KrzysztofGsan/GSM_Project/hardware/PCB/pdf/gi1.pdf

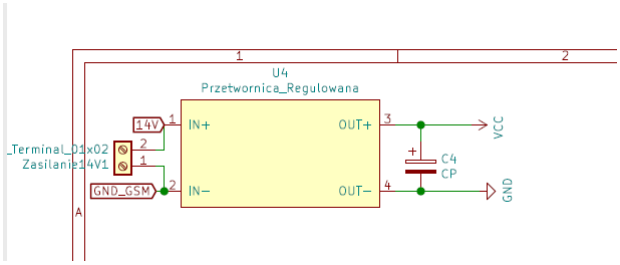
[picture p1: figure]

1. Może warto dodać zabezpieczenie przed odwrotną polaryzacją?
2. Może warto dodać TVS aby zabezpieczyć wejście zasilania przed przepięciami (gdyby np. zasilacz wybuchł :D ).

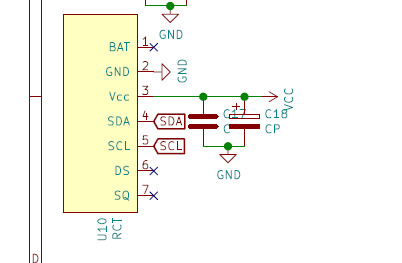
[picture p2: figure]

3. SQ albo DS. – jeden z nich chyba był odnośnie zaprogramowanego alarmu. Może warto podłączyć do wejścia Atmegi?

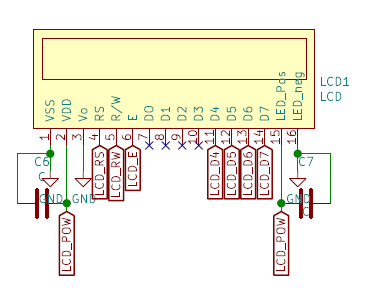
[picture p3: figure]

4. Jakie jest zasilanie LCD? 5V? Jeżeli tak, czemu Vo jest podłączone do masy? Vo to kontrast dla pixeli i sugerował bym dać tam albo potencjometr (5V – Vo – GND) albo podać tam PWM + filtr dolnoprzepustowy.

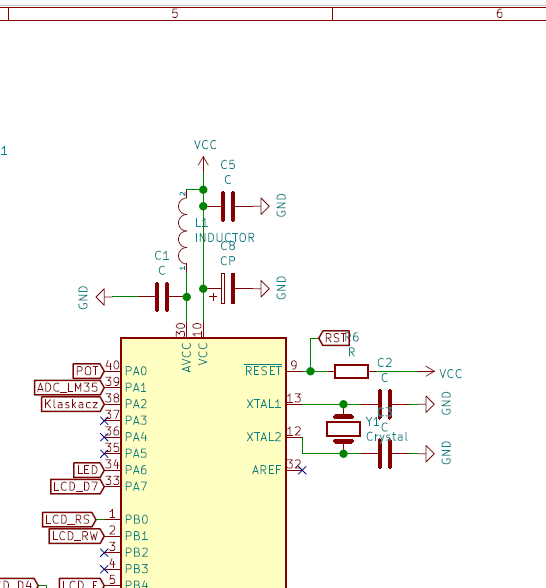
[picture p4: figure]

5. L1 możesz zastąpić rezystorem‐ będzie taniej.
6. Do pinu nr. 9 (reset) dodaj jeszcze 100 nF.

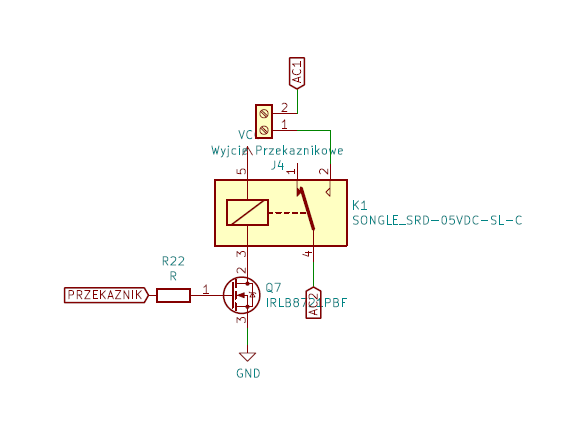
[picture p5: figure]

7. Dodaj diodę do cewki przekaźnika, katodą do Vcc, anoda do tranzystora. Unikniesz przepięć – uszkodzeń tranzystora.

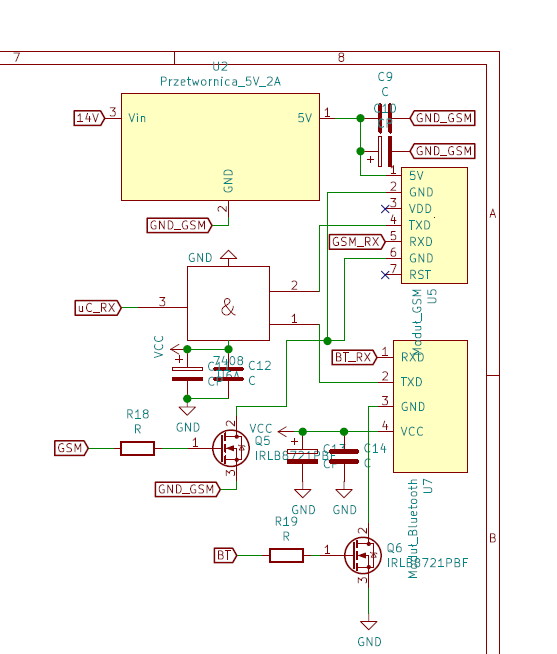
[picture p6: figure]

8. Jak w punkcie 1 i 2 – wspólne dla wejścia zasilania.
