KrzysztofGsan/GSM_Project/hardware/PCB/pdf/GSM_ATMEGA16A.pdf

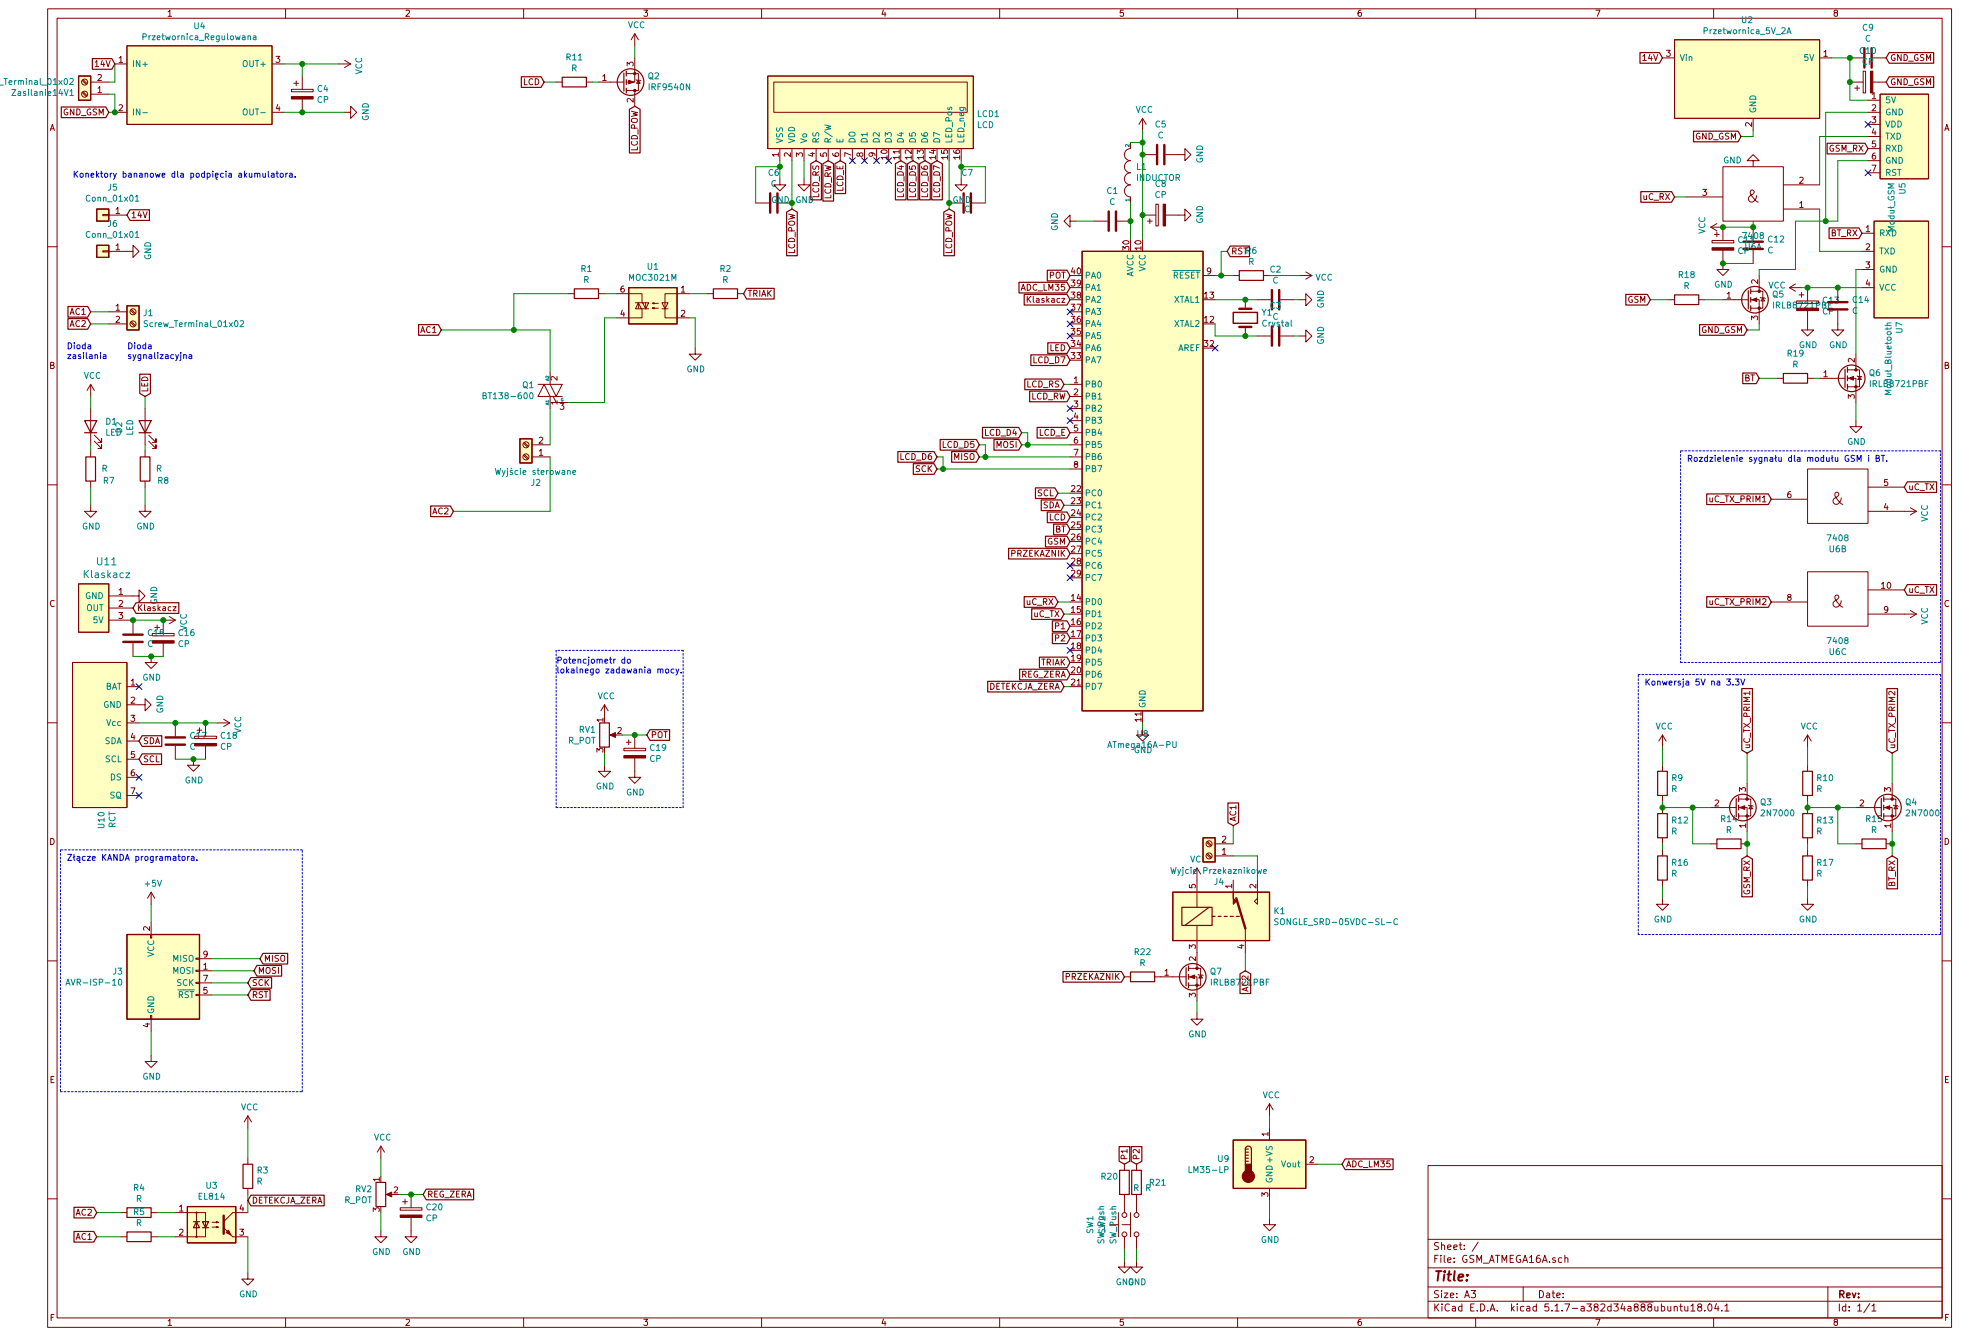
[picture p7: page 1]

File: GSM_ATMEGA16A.sch Sheet: / GND

Konektory bananowe dla podpicia akumulatora.

Rozdzielenie sygnau dla moduu GSM i BT.
