KrzysztofGsan/GSM_Project/hardware/PCB/pdf/GSM_ATMEGA16A-B_Cu.pdf

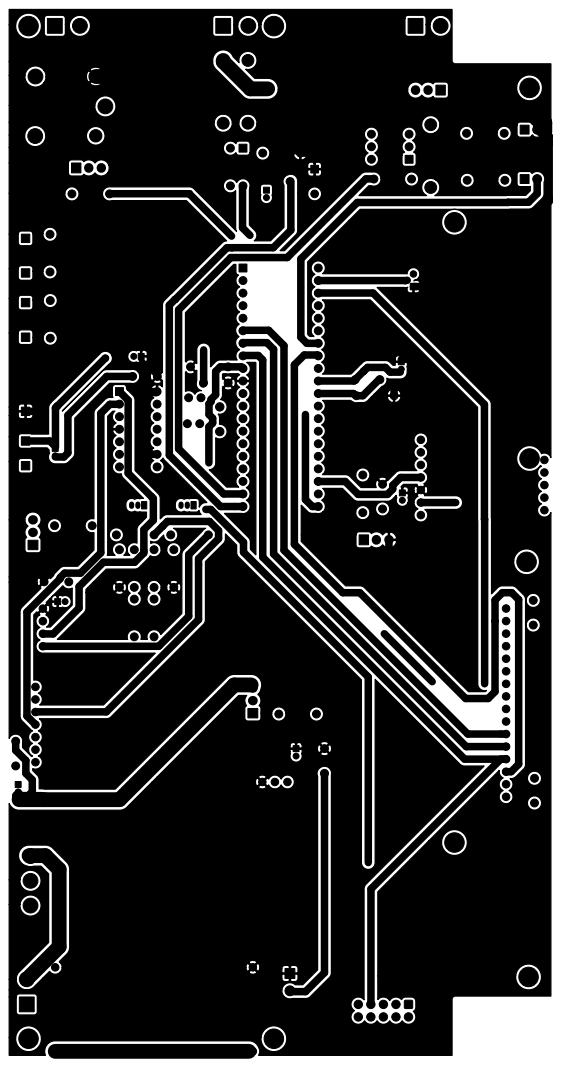
[picture p8: page 1]
