KrzysztofGsan/GSM_Project/hardware/PCB/pdf/GSM_ATMEGA16A-F_SilkS.pdf

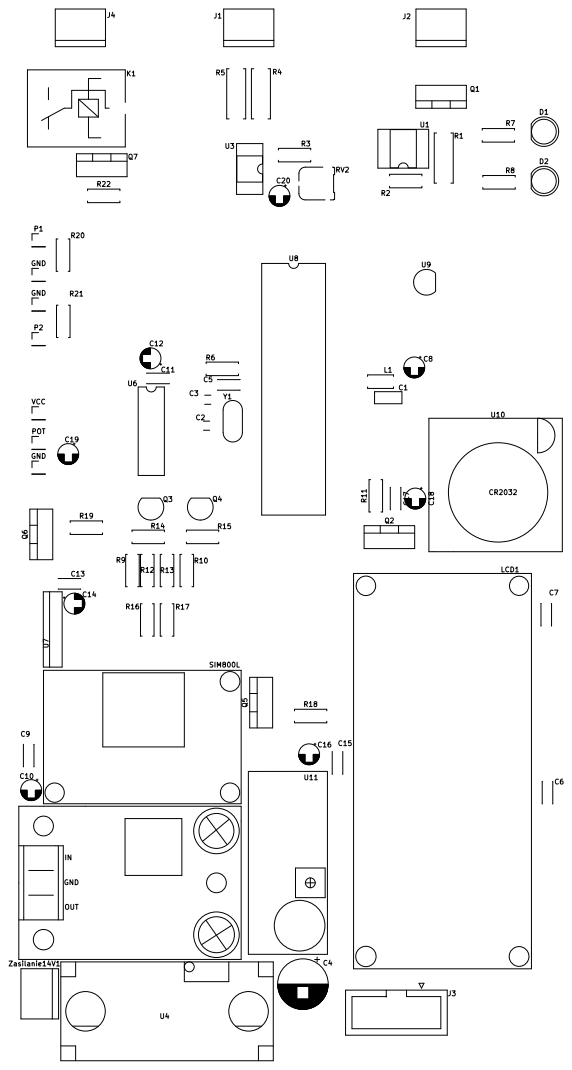
[picture p9: page 1]
