KrzysztofGsan/GSM_Project/hardware/PCB/GSM_ATMEGA16A.kicad_pcb

## KiCad design hardware/PCB/GSM_ATMEGA16A.kicad_pcb (2026-05-25)

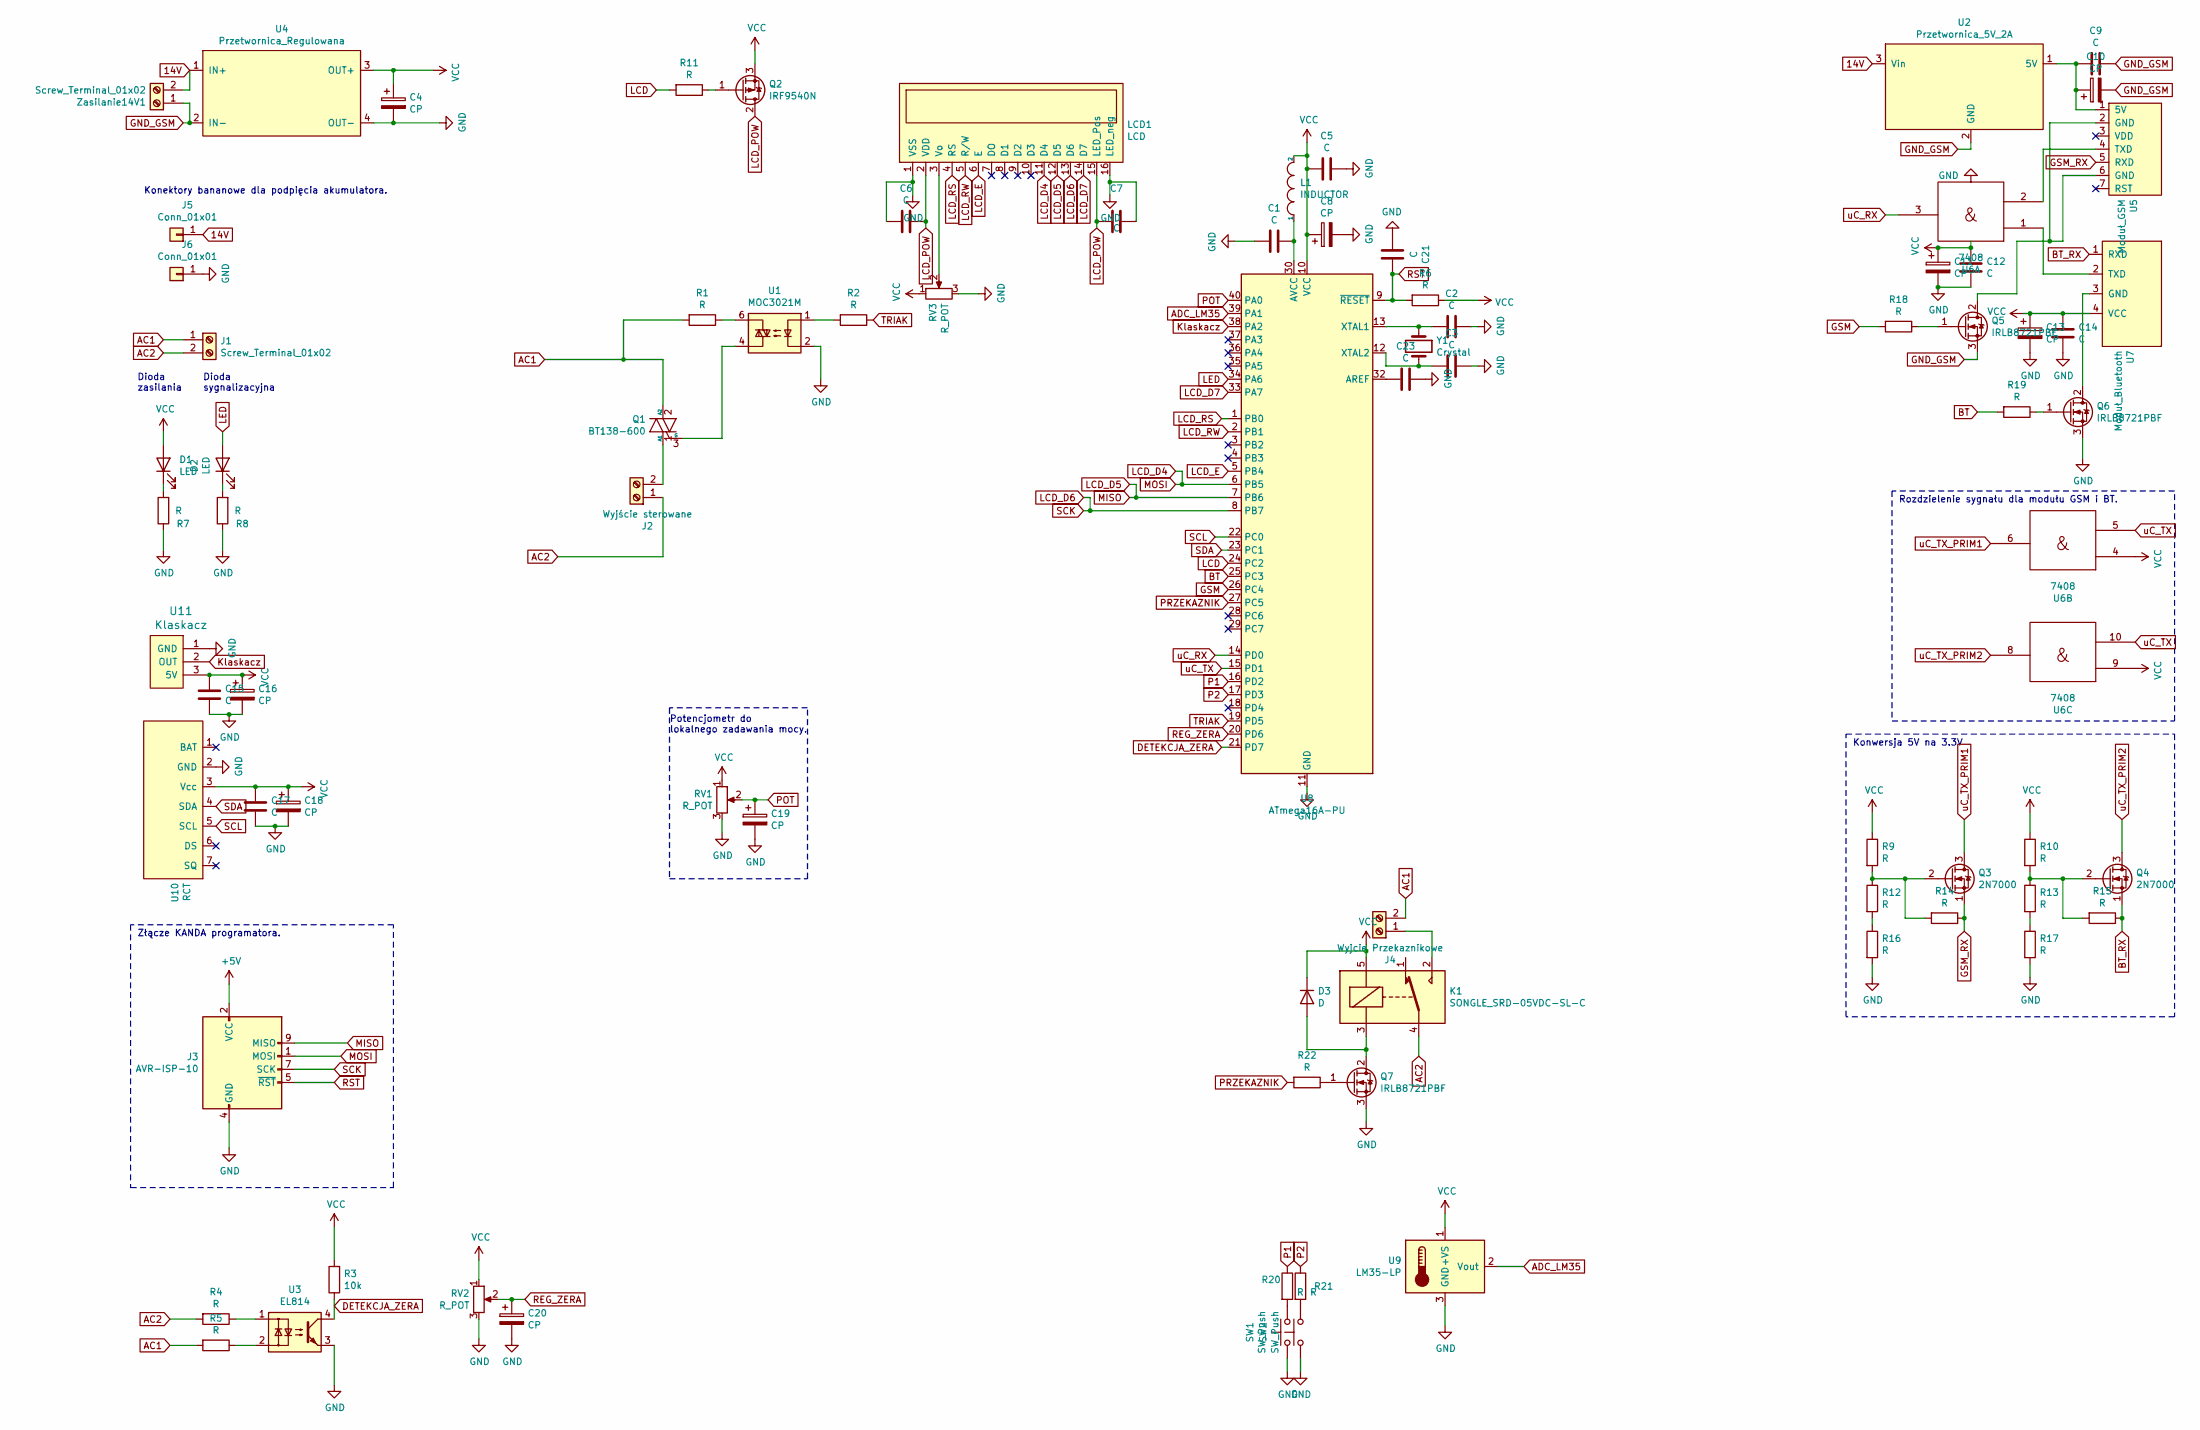
[picture p10: schematic GSM_ATMEGA16A.sch]

Parts:
C1, C21, C23: C; C_Disc_D5.0mm_W2.5mm_P5.00mm
C2, C3: C; C_Disc_D3.0mm_W1.6mm_P2.50mm
C4: CP; CP_Radial_D10.0mm_P3.50mm
C5, C6, C7, C9, C12, C14, C15, C17: C; C_Disc_D4.3mm_W1.9mm_P5.00mm
C8, C10, C11, C13, C16, C18, C19, C20: CP; CP_Radial_D4.0mm_P1.50mm
D1, D2: LED; LED_D5.0mm_Clear
D3: D; D_T-1_P10.16mm_Horizontal
J1: Screw_Terminal_01x02; TerminalBlock_bornier-2_P5.08mm
J2: Wyjście sterowane; TerminalBlock_bornier-2_P5.08mm
J3: AVR-ISP-10; IDC-Header_2x05_P2.54mm_Vertical
J4: Wyjcie Przekaznikowe; TerminalBlock_bornier-2_P5.08mm
J5, J6: Conn_01x01; Banana_Jack_1Pin
K1: SONGLE_SRD-05VDC-SL-C; Przekaznik_SRD-05VDC-SL-C
L1: INDUCTOR; L_Axial_L5.3mm_D2.2mm_P7.62mm_Horizontal_Vishay_IM-1
LCD1: LCD
Q1: BT138-600; TO-220-3_Vertical
Q2: IRF9540N; TO-220-3_Vertical
Q3, Q4: 2N7000; TO-92_Inline
Q5, Q6, Q7: IRLB8721PBF; TO-220-3_Vertical
R1, R4, R5: R; R_Axial_DIN0411_L9.9mm_D3.6mm_P12.70mm_Horizontal
R2, R6, R7, R8, R9, R10, R11, R12, R13, R14, R15, R16, R17, R18, R19, R20, R21, R22: R; R_Axial_DIN0207_L6.3mm_D2.5mm_P7.62mm_Horizontal
R3: 10k; R_Axial_DIN0207_L6.3mm_D2.5mm_P7.62mm_Horizontal
RV1: R_POT; Potentiometer_Omeg_PC16BU_Vertical
RV2, RV3: R_POT; Potentiometer_Runtron_RM-065_Vertical
SW1, SW2: SW_Push; SW_PUSH-12mm
U1: MOC3021M; DIP-6_W7.62mm_Socket
U2: Przetwornica_5V_2A
U3: EL814; DIP-4_W7.62mm_Socket
U4: Przetwornica_Regulowana; PrzetwornicaRegulowana
U5: Moduł_GSM; Modul_GSM
U6: 7408; DIP-14_W7.62mm
U7: Moduł_Bluetooth; Modul_BT
U8: ATmega16A-PU; DIP-40_W15.24mm
U9: LM35-LP; TO-92
U10: RCT
U11: Klaskacz
Y1: Crystal; Resonator-2Pin_W8.0mm_H3.5mm
Zasilanie14V1: Screw_Terminal_01x02; TerminalBlock_bornier-2_P5.08mm

Connections:
14V: J5.1, U2.3 (Vin), U4.1 (IN+), Zasilanie14V1.2
+5V: J3.2 (VCC)
AC1: J1.1, J4.2, Q1.2 (A2), R1.2, R5.2
AC2: J1.2, J2.1, K1.4, R4.2
ADC_LM35: U8.39 (PA1), U9.2 (Vout)
BT: R19.2, U8.25 (PC3)
BT_RX: Q4.1 (S), R15.1, U7.1 (RXD)
DETEKCJA_ZERA: R3.1, U3.4, U8.21 (PD7)
GND: C1.2, C2.1, C3.1, C4.2, C5.1, C6.2, C7.1, C8.2, C11.2, C12.1, C13.2, C14.1, C15.2, C16.2, C17.2, C18.2, C19.2, C20.2, C21.2, C23.1, J3.4 (GND), J3.6 (GND), J3.8 (GND), J3.10 (GND), J6.1, LCD1.1 (VSS), LCD1.16 (LED_neg), Q6.3 (S), Q7.3 (S), R7.1, R8.1, R16.2, R17.2, RV1.3, RV2.3, RV3.3, SW1.1, SW2.1, U1.2, U3.3, U4.4 (OUT-), U6.7 (Gnd), U8.11 (GND), U8.31 (GND), U9.3 (GND), U10.2 (GND), U11.1 (GND); also elsewhere on the board
GND_GSM: C9.1, C10.2, Q5.3 (S), U2.2 (GND), U4.2 (IN-), Zasilanie14V1.1
GSM: R18.2, U8.26 (PC4)
GSM_RX: Q3.1 (S), R14.1, U5.5 (RXD)
Klaskacz: U8.38 (PA2), U11.2 (OUT)
LCD: R11.2, U8.24 (PC2)
LCD_D4: J3.1 (MOSI), LCD1.11 (D4), U8.6 (PB5)
LCD_D5: J3.9 (MISO), LCD1.12 (D5), U8.7 (PB6)
LCD_D6: J3.7 (SCK), LCD1.13 (D6), U8.8 (PB7)
LCD_D7: LCD1.14 (D7), U8.33 (PA7)
LCD_E: LCD1.6 (E), U8.5 (PB4)
LCD_POW: C6.1, C7.2, LCD1.2 (VDD), LCD1.15 (LED_Pos), Q2.2 (D)
LCD_RS: LCD1.4 (RS), U8.1 (PB0)
LCD_RW: LCD1.5 (R/W), U8.2 (PB1)
LED: D2.2 (A), U8.34 (PA6)
unnamed: C1.1, L1.1, U8.30 (AVCC)
unnamed: C2.2, U8.13 (XTAL1), Y1.1
unnamed: C3.2, U8.12 (XTAL2), Y1.2
unnamed: C9.2, C10.1, U2.1 (5V), U5.1 (5V)
unnamed: C23.2, U8.32 (AREF)
unnamed: D1.1 (K), R7.2
unnamed: D2.1 (K), R8.2
unnamed: D3.2 (A), K1.3, Q7.2 (D)
unnamed: J2.2, Q1.1 (A1)
unnamed: J4.1, K1.2
unnamed: LCD1.3 (Vo), RV3.2
unnamed: Q1.3 (G), U1.4
unnamed: Q2.1 (G), R11.1
unnamed: Q3.2 (G), R9.2, R12.1, R14.2
unnamed: Q4.2 (G), R10.2, R13.1, R15.2
unnamed: Q5.1 (G), R18.1
unnamed: Q5.2 (D), U5.2 (GND), U5.6 (GND)
unnamed: Q6.1 (G), R19.1
unnamed: Q6.2 (D), U7.3 (GND)
unnamed: Q7.1 (G), R22.1
unnamed: R1.1, U1.6
unnamed: R2.2, U1.1
unnamed: R4.1, U3.1
unnamed: R5.1, U3.2
unnamed: R12.2, R16.1
unnamed: R13.2, R17.1
unnamed 55: R20.2, SW1.2; also elsewhere on the board
unnamed 56: R21.2, SW2.2; also elsewhere on the board
unnamed: U5.4 (TXD), U6.2
unnamed: U6.1, U7.2 (TXD)
P1: R20.1, U8.16 (PD2)
P2: R21.1, U8.17 (PD3)
POT: C19.1, RV1.2, U8.40 (PA0); also elsewhere on the board
PRZEKAZNIK: R22.2, U8.27 (PC5)
REG_ZERA: C20.1, RV2.2, U8.20 (PD6)
RST: C21.1, J3.5 (~RST), R6.2, U8.9 (~RESET)
SCL: U8.22 (PC0), U10.5 (SCL)
SDA: U8.23 (PC1), U10.4 (SDA)
TRIAK: R2.1, U8.19 (PD5)
VCC: C4.1, C5.2, C8.1, C11.1, C12.2, C13.1, C14.2, C15.1, C16.1, C17.1, C18.1, D1.2 (A), D3.1 (K), K1.5, L1.2, Q2.3 (S), R3.2, R6.1, R9.1, R10.1, RV1.1, RV2.1, RV3.1, U4.3 (OUT+), U6.4, U6.9, U6.14 (Vcc), U7.4 (VCC), U8.10 (VCC), U9.1 (+VS), U10.3 (Vcc), U11.3 (5V); also elsewhere on the board
uC_RX: U6.3, U8.14 (PD0)
uC_TX: U6.5, U6.10, U8.15 (PD1)
uC_TX_PRIM1: Q3.3 (D), U6.6
uC_TX_PRIM2: Q4.3 (D), U6.8

Notes on the sheet:
Rozdzielenie sygnału dla modułu GSM i BT.
Konwersja 5V na 3.3V
Potencjometr do lokalnego zadawania mocy.
Złącze KANDA programatora.
Dioda zasilania
Dioda sygnalizacyjna
Konektory bananowe dla podpięcia akumulatora.

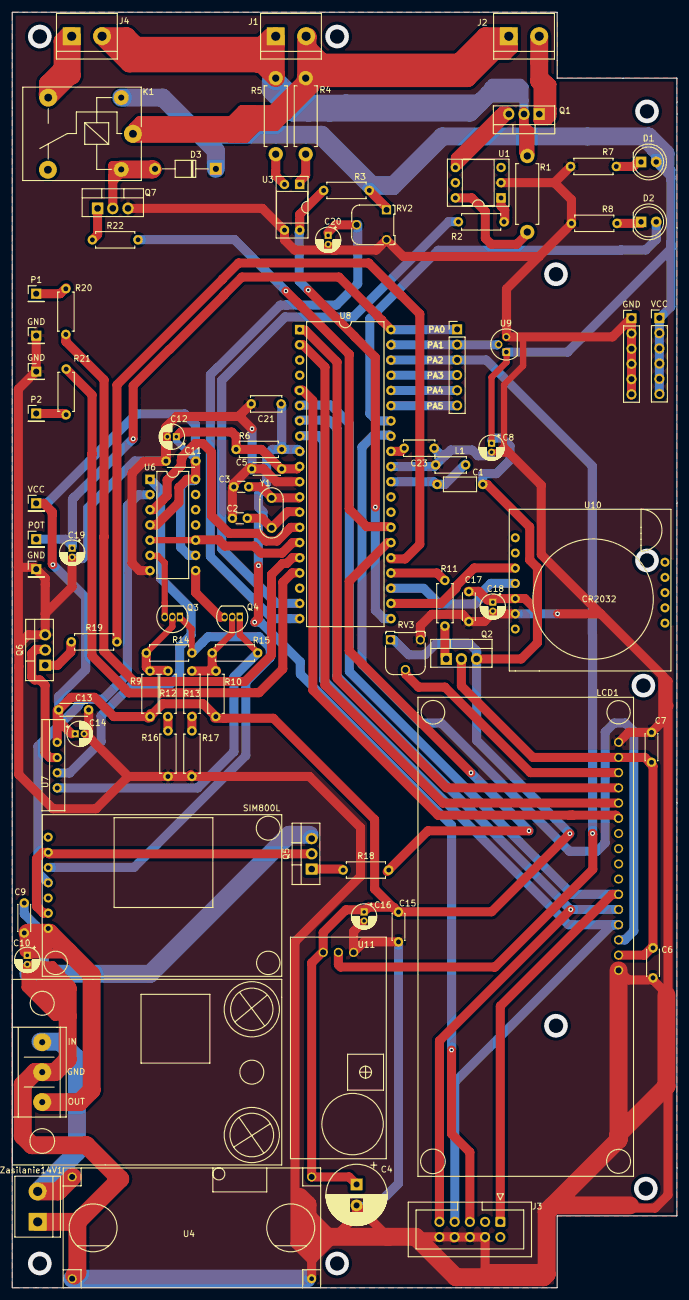
[picture p11: board GSM_ATMEGA16A.kicad_pcb from above]

Board: 2 copper layers, 111.0 x 213.0 mm, 85 parts (0 on the bottom side), 66 nets.

Other parts of the board:
GND: PinHeader_1x06_P2.54mm_Vertical
GND#2, GND#3, GND#4: PinHeader_1x01_P2.54mm_Vertical
P1, P2: PinHeader_1x01_P2.54mm_Vertical
POT: PinHeader_1x01_P2.54mm_Vertical
VCC: PinHeader_1x06_P2.54mm_Vertical
VCC#2: PinHeader_1x01_P2.54mm_Vertical

Their connections:
GND: GND#2.1, GND#3.1, GND#4.1; also elsewhere on the board
unnamed 55: P1.1; also elsewhere on the board
unnamed 56: P2.1; also elsewhere on the board
POT: POT.1; also elsewhere on the board
VCC: VCC#2.1; also elsewhere on the board
