KrzysztofGsan/GSM_Project/(commit log)

2024-03-18 ADC - dodanie klaskacza. temp
2026-04-22 Initialize README with project details and instructions
    Added project overview, key features, current status, and build instructions to README.
2026-05-25 KGR: dodano pliki KiCad
